StepanenkovAnton/RaspberryPI-MAX11046-ADC-hat/PIC.jpg

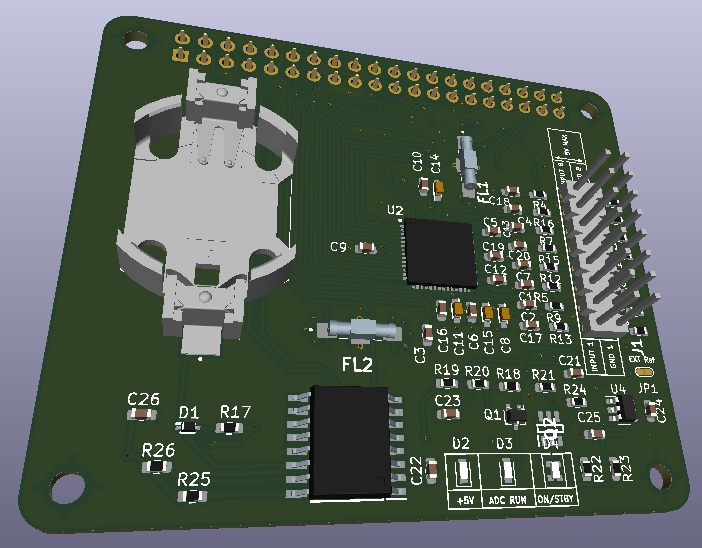
PIC.jpg
