StepanenkovAnton/RaspberryPI-MAX11046-ADC-hat/Manufactoring Documentation/smuHAT_image.jpg

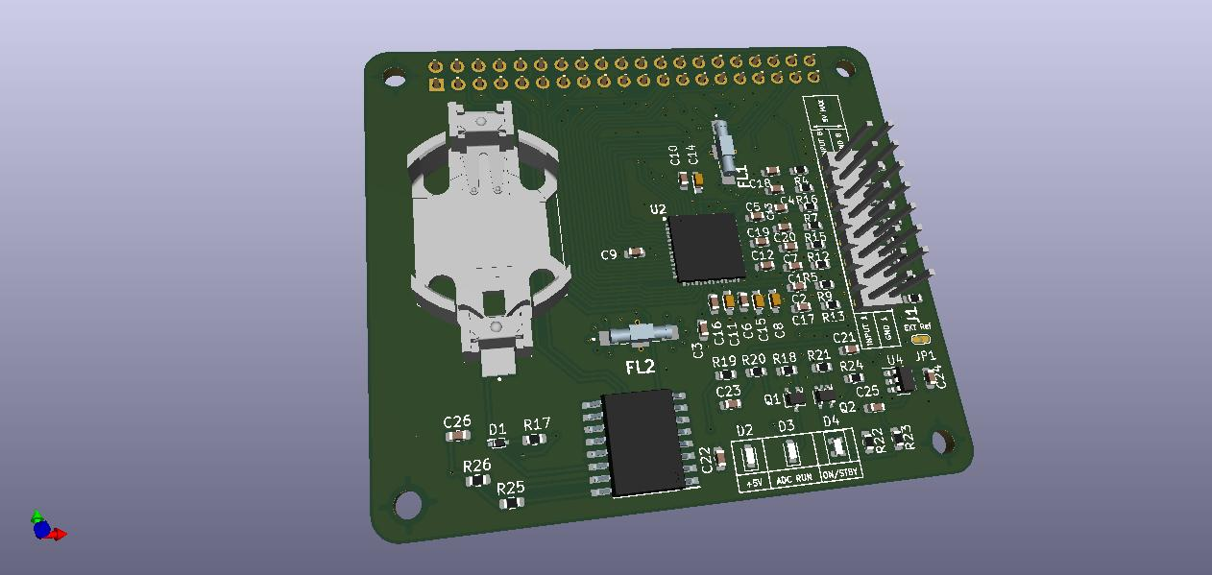
Manufactoring Documentation/smuHAT_image.jpg
