StepanenkovAnton/RaspberryPI-MAX11046-ADC-hat/README.md

# RaspberryPI-MAX11046-ADC-hat
The Raspberry PI add-on boad with the 16 bit 6-channel ADC intended for 3 voltage + 3 current channels high-speed sampling in order to measure the power net
quality parameters like harmonics, power coefficient and so forth.
