StepanenkovAnton/RaspberryPI-MAX11046-ADC-hat/Manufactoring Documentation/LayersStack.jpg

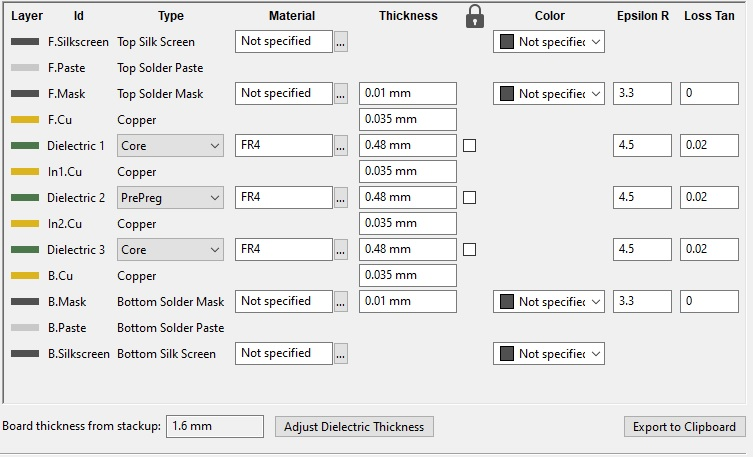
Manufactoring Documentation/LayersStack.jpg
