StepanenkovAnton/RaspberryPI-MAX11046-ADC-hat/Manufactoring Documentation/Bill Of Materials.xlsx

Schematic Position | Value | Footprint | Datasheet | Description | Brand | Mfr. Part number | Qty | Price INR | Total
> C8, C11, C14, C15 | 33uF | smu:CAPPM169X90N | https://www.mouser.in/datasheet/2/40/AVX_F98_DTSH_08_16-1158749.pdf | CAPACITOR TANTALUM SOLID RESIN-MOLDED CHIP, HIGH CV UNDERTAB | KYOCERA AVX (https://www.mouser.in/manufacturer/kyocera-avx/) | F981A336MMALZT | 4 | 64.31 | 257.24
> C3, C5, C6, C9, C10, C12, C16, C19, C21, C22, C26 | 100nF | Capacitor_SMD:C_0603_1608Metric | https://www.mouser.in/datasheet/2/40/AutoMLCC-777028.pdf | Multilayer Ceramic Capacitors MLCC - SMD/SMT 50V 10pF C0G 0603 1% AEC-Q200 | KYOCERA AVX (https://www.mouser.in/manufacturer/kyocera-avx/) | 06035A100F4T4A | 11 | 35 | 385
> C1, C2, C4, C7, C13, C17, C18, C20 | 22nF | Capacitor_SMD:C_0603_1608Metric | https://www.mouser.in/datasheet/2/281/murata_03052018_GRM_Series_1-1310166.pdf | Multilayer Ceramic Capacitors MLCC - SMD/SMT 1500PF 50V 1% 0603 | Murata Electronics (https://www.mouser.in/manufacturer/murataelectronics/) | GRM1885C1H152FA01D | 8 | 13.02 | 104.16
C24 | 1n | Capacitor_SMD:C_0603_1608Metric | https://product.tdk.com/system/files/dam/doc/product/capacitor/ceramic/mlcc/catalog/mlcc_commercial_general_en.pdf | Multilayer Ceramic Capacitors MLCC - SMD/SMT RECOMMENDED ALT 810-C0603X7R1E102K | TDK (https://www.mouser.in/manufacturer/tdk/) | C0603X7R1E102M030BA | 1 | 8.14 | 8.14
> C23, C25 | 10u | Capacitor_SMD:C_0603_1608Metric | https://www.mouser.in/datasheet/2/40/cx5r-776519.pdf | Multilayer Ceramic Capacitors MLCC - SMD/SMT 25V 10uF X5R 0603 20% | KYOCERA AVX (https://www.mouser.in/manufacturer/abracon/) | 06033D106MAT2A | 2 | 29.3 | 58.6
D1 | 1N4148WT | smu:SODFL1608X70N | https://componentsearchengine.com/Datasheets/2/1N4148WT.pdf | ON SEMICONDUCTOR - 1N4148WT - DIODE, SWITCHING, 75V, SOD-523F-2 | onsemi | 1N4148WT | 1 | 16.28 | 16.28
D2 | BLUE | smu:WL-SMCC | https://www.we-online.com/catalog/datasheet/150060BS73220.pdf |  | Wurth Elektronik (https://www.mouser.in/manufacturer/wurth-elektronik/) | 150060BS73220 | 1 | 26.86 | 26.86
D3 | YELLOW | smu:WL-SMCC | https://www.we-online.com/catalog/datasheet/150060YS73220.pdf |  | Wurth Elektronik (https://www.mouser.in/manufacturer/wurth-elektronik/) | 150060YS73220 | 1 | 26.86 | 26.86
D4 | LED_Dual_CCAA | smu:WL-SBCC | https://www.we-online.com/catalog/datasheet/150060RV75240.pdf |  | Wurth Elektronik (https://www.mouser.in/manufacturer/wurth-elektronik/) | 150060RV75240 | 1 | 60.24 | 60.24
> FL1, FL2 | NFE61PT472C1H9L | smu:NFE61 | https://www.murata.com/en-us/products/productdetail?partno=NFE61PT472C1H9%23 | SMT EMI filter capacitor,4700pF 50Vdc Murata NFE61HT / PT Series 2A 50 V dc SMD Power Line Filter, with Solder Pad Terminals | Murata Electronics | NFE61PT472C1H9L | 2 | 63.49 | 126.98
J1 | 5-146253-8 | smu:HDRV16W68P254_2X8_1991X488X1045P | https://www.mouser.fr/datasheet/2/418/6/ENG_CD_146253_J3-2007644.pdf | 16 MODII HDR DRST B/A .100CL LF | TE Connectivity | 5-146253-8 | 1 | 346.76 | 346.76
J2 | RPI_header | Connector_PinSocket_2.54mm:PinSocket_2x20_P2.54mm_Vertical | https://suddendocs.samtec.com/catalog_english/ssq_th.pdf |  | Samtec (https://www.mouser.in/manufacturer/samtec/) | SSQ-120-01-F-D | 1 | 560.85 | 560.85
Q1 | XP231N02013R | Package_TO_SOT_SMD:SOT-323_SC-70 | https://eu.mouser.com/datasheet/2/760/TOSL_S_A0010841704_1-2575097.pdf | MOSFET N-CHANNEL 30V 0.2A |  | Torex Semiconductor (https://www.mouser.in/manufacturer/torex-semiconductor/) | 1 | 28.49 | 28.49
Q2 | SQ1922EEH-T1_GE3 | Package_TO_SOT_SMD:SOT-353_SC-70-5 | https://www.mouser.com.tr/datasheet/2/427/sq1922eeh-1766298.pdf |  |  |  | 1 | 30 | 30
> R1-R3, R6, R8, R10, R11, R14 | 100 | Resistor_SMD:R_0603_1608Metric | https://www.mouser.in/datasheet/2/315/AOA0000C307-1149632.pdf | Thin Film Resistors - SMD 0603 536ohm 0.1% 25ppm | Panasonic (https://www.mouser.in/manufacturer/panasonicec/) | ERA-3AEB5360V | 8 | 28.49 | 227.92
> R4, R5, R7, R9, R12, R13, R15-R17 | 1K | Resistor_SMD:R_0603_1608Metric | https://www.mouser.in/datasheet/2/447/PYu_RC_Group_51_RoHS_L_11-1984063.pdf | Thick Film Resistors - SMD 1 kOhms 100mW 0603 1% | YAGEO (https://www.mouser.in/manufacturer/yageo/) | RC0603FR-071KL | 9 | 8.14 | 73.26
> R18, R21, R24 | 10k | Resistor_SMD:R_0603_1608Metric | https://www.mouser.in/datasheet/2/447/PYu_RC_Group_51_RoHS_L_11-1984063.pdf | Thick Film Resistors - SMD 10 kOhms 100mW 0603 1% | YAGEO (https://www.mouser.in/manufacturer/yageo/) | RC0603FR-0710KL | 3 | 8.14 | 24.42
> R19, R20, R22, R23 | 270 | Resistor_SMD:R_0603_1608Metric | https://www.mouser.in/datasheet/2/447/PYu_AR_51_RoHS_L_7-3003081.pdf | Thick Film Resistors - SMD 270Ohms 1/10W 0603 5% | YAGEO (https://www.mouser.in/manufacturer/yageo/) | AR0603JR-07270RL | 4 | 25.23 | 100.92
> R25, R26 | 2K | Resistor_SMD:R_0603_1608Metric | https://www.mouser.in/datasheet/2/351/Xicon_09112019_XC-600033-1667099.pdf | Thick Film Resistors - SMD 1/10WATT 2KOHMS 5% | Xicon (https://www.mouser.in/manufacturer/xicon/) | SDR03EZPD2001 | 2 | 10 | 20
U1 | SMTU2032-LF | smu:SMTU2032LF | https://www.mouser.com.tr/datasheet/2/427/sq1922eeh-1766298.pdf | Coin Cell Battery Holders SFC MNT FOR CR2032 | RENATA | SMTU2032-LF | 1 | 51.28 | 51.28
U2 | MAX11046ETN+ | smu:QFN50P800X800X80-57N | https://datasheet.datasheetarchive.com/originals/distributors/Datasheets-DGA17/1032187.pdf | MAX11046ETN+, 16 bit ADC 8-channel, Parallel, 56-Pin TQFN | Maxim Integrated | MAX11046ETN+ | 1 | 2882.37 | 2882.37
U3 | DS3231M+TRL | smu:SOIC127P1032X265-16N | http://componentsearchengine.com/Datasheets/1/DS3231M+TRL.pdf | +/-5ppm, I2C Real-Time Clock | Maxim Integrated | DS3231M+TRL | 1 | 789 | 789
U4 | REF34xxT | Package_TO_SOT_SMD:SOT-23-6 | https://www.ti.com/lit/ds/symlink/ref3440.pdf |  |  | Substitute-REF3240AIDBVT | 1 | 602 | 602
 |  |  |  |  |  | REF3440TIDBVR |  | Total | 6807.63
