StepanenkovAnton/RaspberryPI-MAX11046-ADC-hat/Schematic_diagram.pdf

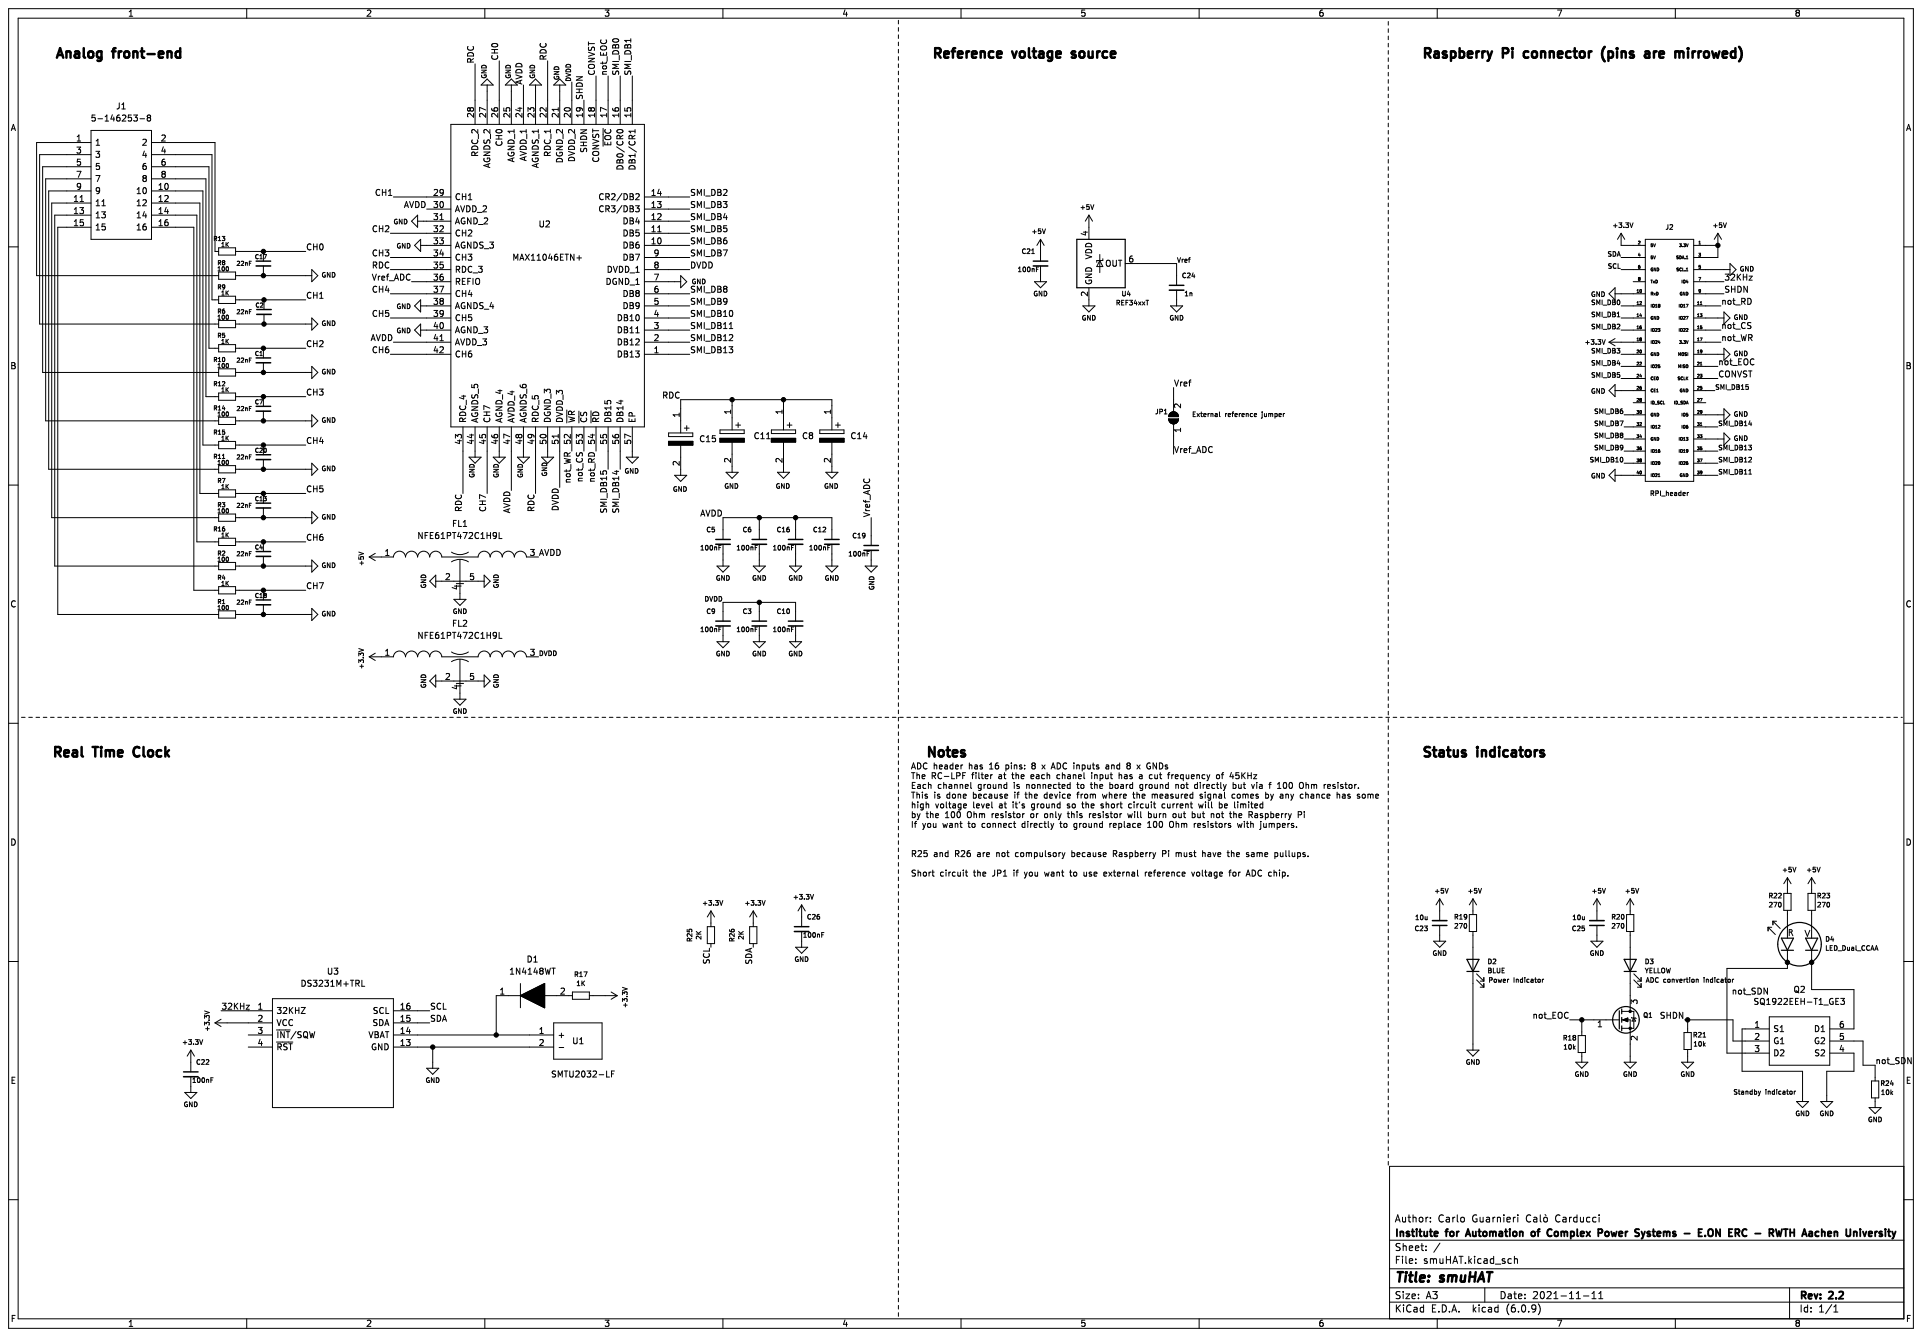
[picture p4: page 1]
