StepanenkovAnton/RaspberryPI-MAX11046-ADC-hat/Manufactoring Documentation/Schematic diagram.pdf

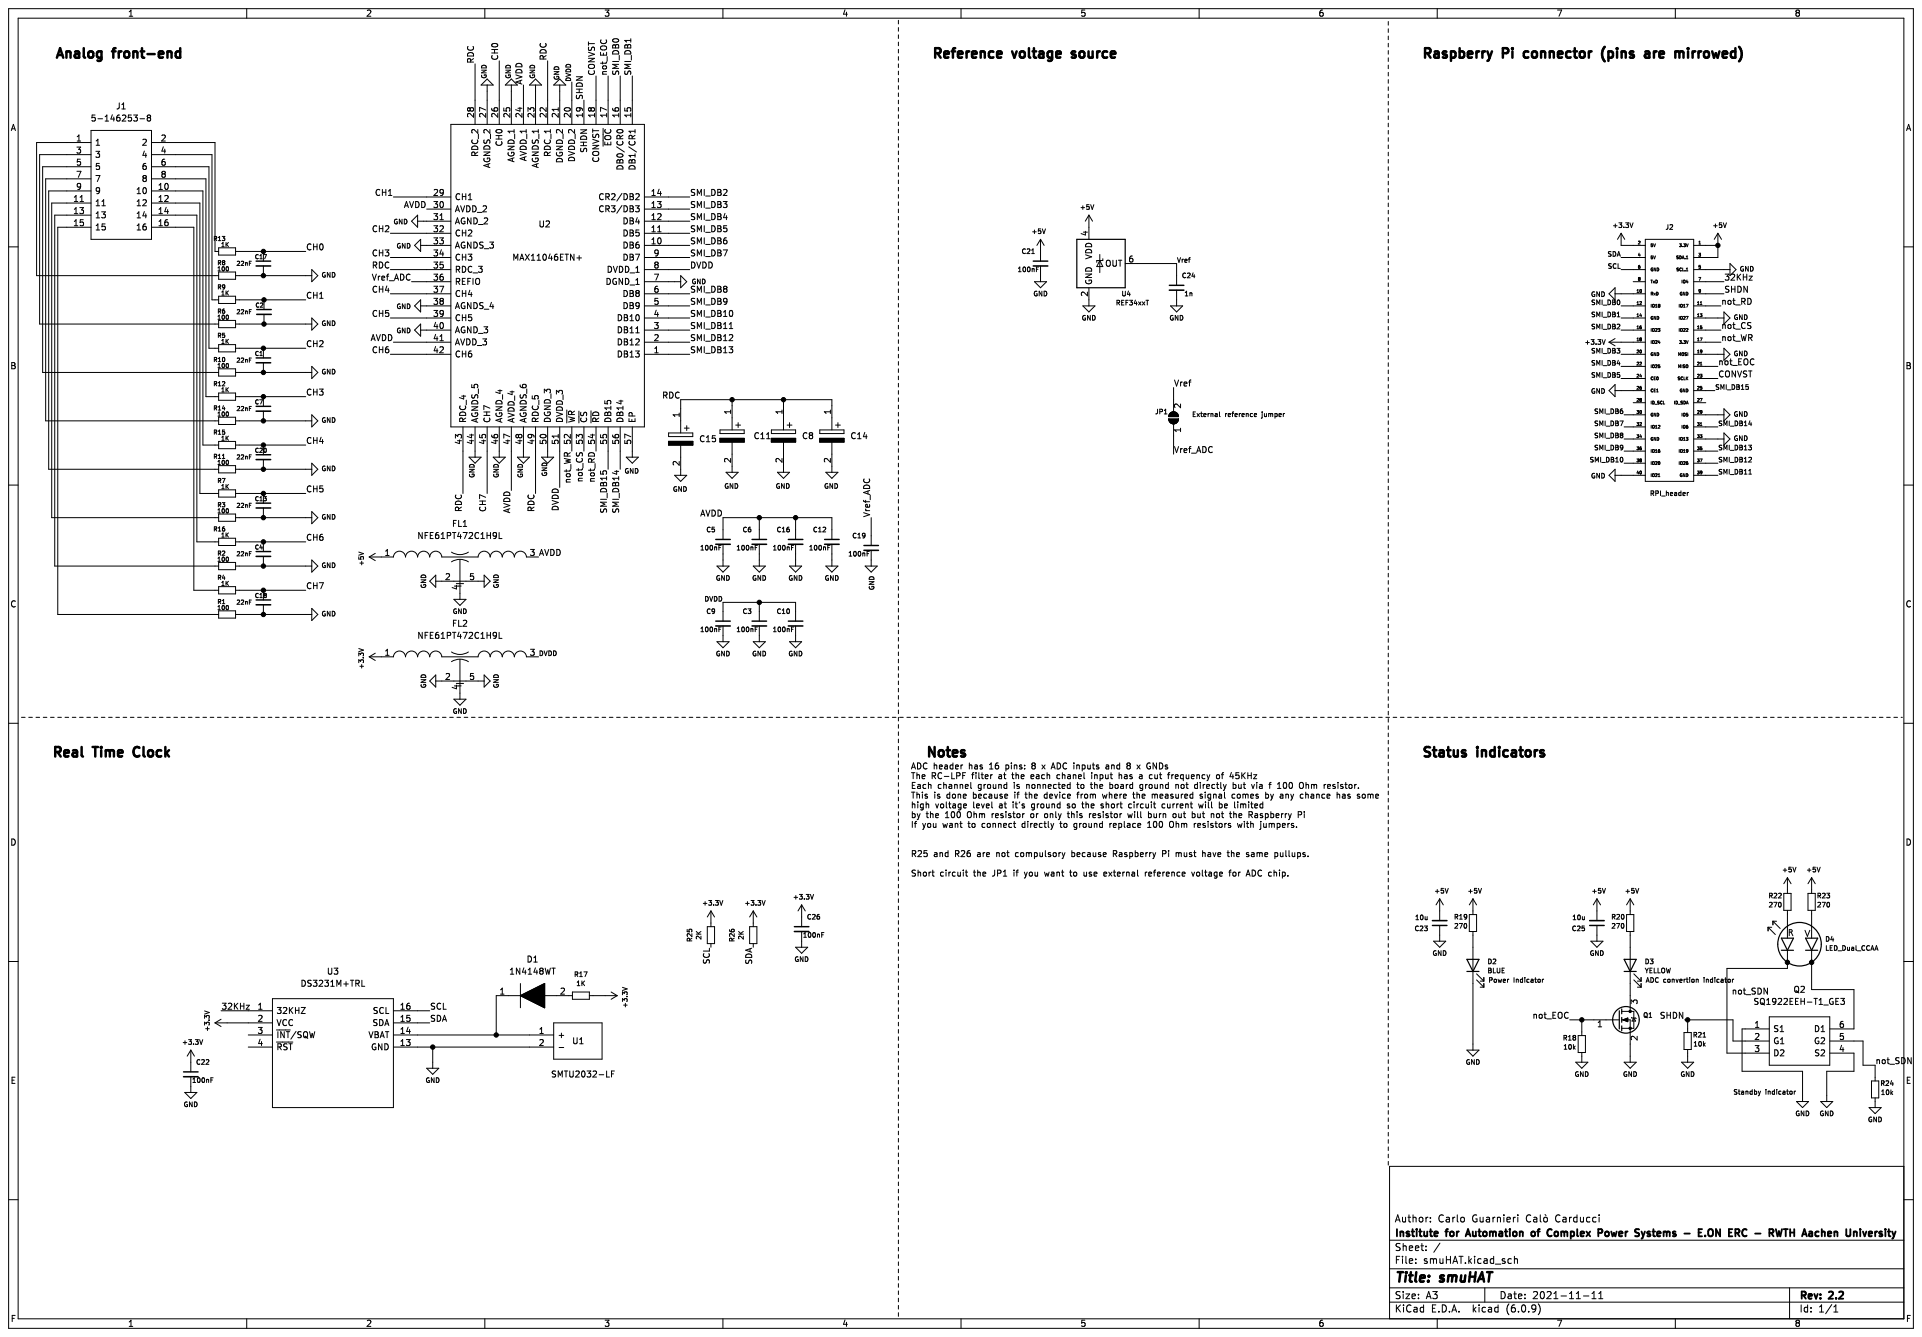
[picture p5: page 1]
