StepanenkovAnton/RaspberryPI-MAX11046-ADC-hat/smuHAT.kicad_pcb

## KiCad design smuHAT.kicad_pcb (2023-01-25)

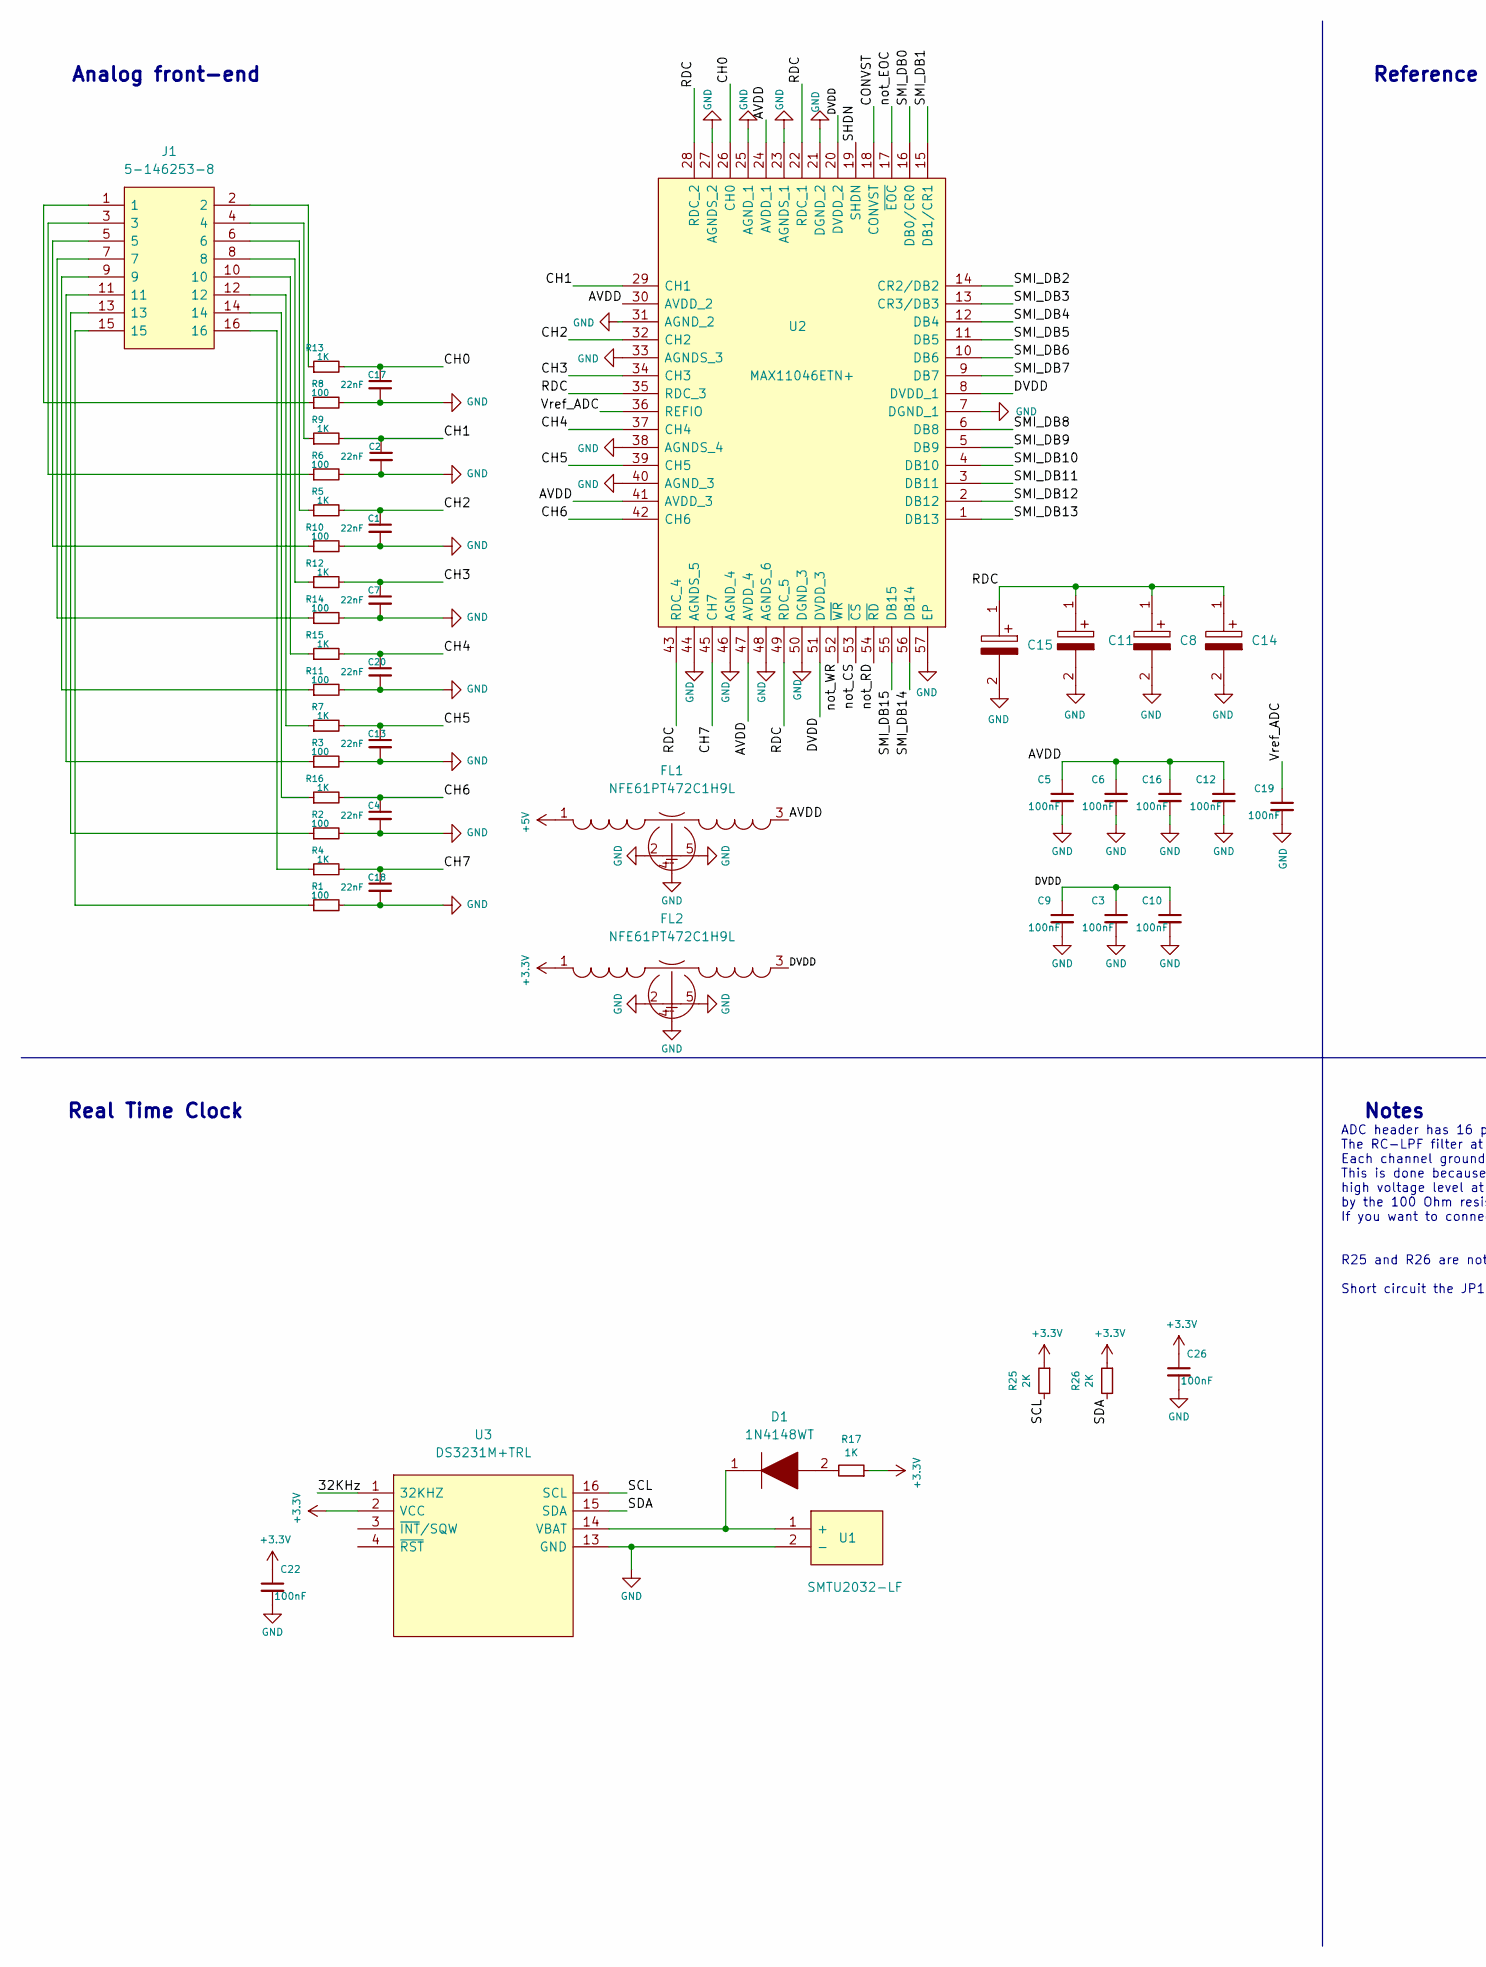
[picture p6: schematic smuHAT.kicad_sch, part in row 1, column 1]

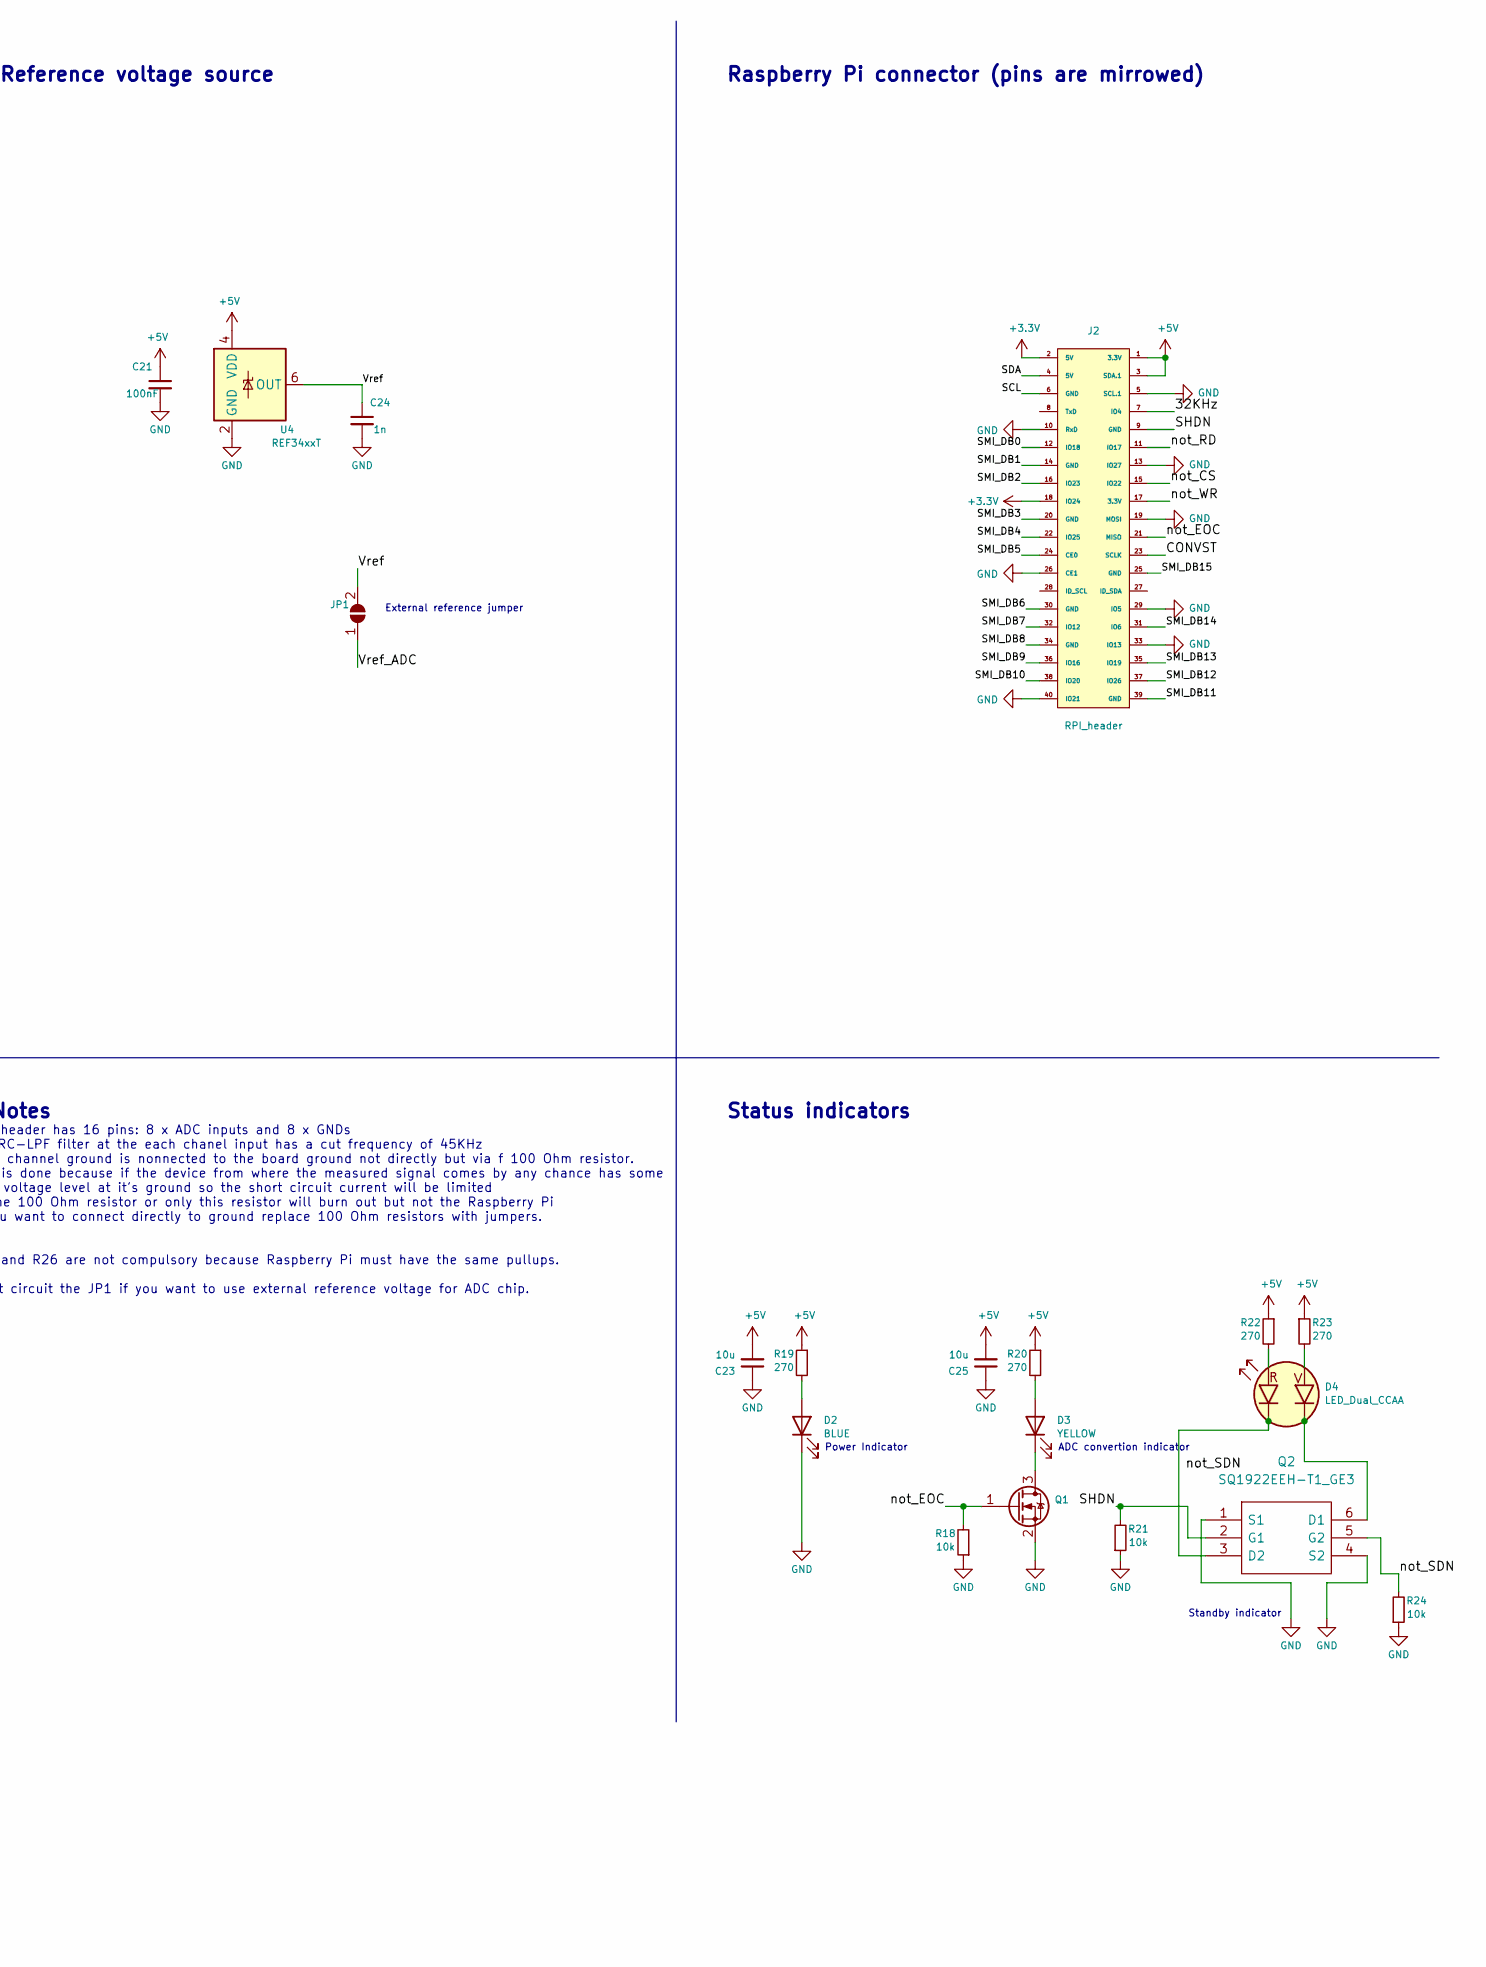
[picture p7: schematic smuHAT.kicad_sch, part in row 1, column 2]

Parts:
C1, C2, C4, C7, C13, C17, C18, C20: 22nF; C_0603_1608Metric
C3, C5, C6, C9, C10, C12, C16, C19, C21, C22, C26: 100nF; C_0603_1608Metric
C8, C11, C14, C15: 33uF; CAPPM169X90N; Mouser Part Number 581-F981A336MMALZT
C23, C25: 10u; C_0603_1608Metric
C24: 1n; C_0603_1608Metric
D1: 1N4148WT; SODFL1608X70N; Mouser Part Number 512-1N4148WT
D2: BLUE; WL-SMCC
D3: YELLOW; WL-SMCC
D4: LED_Dual_CCAA; WL-SBCC
FL1, FL2: NFE61PT472C1H9L; NFE61; Mouser Part Number 81-NFE61PT472C1H9L
J1: 5-146253-8; HDRV16W68P254_2X8_1991X488X1045P; Mouser Part Number 571-5-146253-8
J2: RPI_header; PinSocket_2x20_P2.54mm_Vertical
JP1: External ref. voltage; SolderJumper-2_P1.1mm_Open_RoundedPad0.8x0.9mm
Q1: XP231N02013R; SOT-323_SC-70
Q2: SQ1922EEH-T1_GE3; SOT95P284X110-6N; Mouser Part Number 78-SQ1922EEH-T1_GE3
R1, R2, R3, R6, R8, R10, R11, R14: 100; R_0603_1608Metric
R4, R5, R7, R9, R12, R13, R15, R16, R17: 1K; R_0603_1608Metric
R18, R21, R24: 10k; R_0603_1608Metric
R19, R20, R22, R23: 270; R_0603_1608Metric
R25, R26: 2K; R_0603_1608Metric
U1: SMTU2032-LF; SMTU2032LF; Mouser Part Number 614-SMTU2032-LF
U2: MAX11046ETN+; QFN50P800X800X80-57N; Mouser Part Number 700-MAX11046ETN
U3: DS3231M+TRL; SOIC127P1032X265-16N; Mouser Part Number 700-DS3231M+TRL
U4: REF34xxT; SOT-23-6

Connections:
+3.3V: C22.1, C26.1, FL2.1, J2.2 (5V), J2.18 (IO24), R17.1, R25.1, R26.1, U3.2 (VCC)
+5V: C21.1, C23.2, C25.2, FL1.1, J2.1 (3.3V), J2.3 (SDA.1), R19.1, R20.1, R22.1, R23.1, U4.4 (VDD)
/32KHz: J2.7 (IO4), U3.1 (32KHZ)
/AVDD: C5.1, C6.1, C12.1, C16.1, FL1.3, U2.24 (AVDD_1), U2.30 (AVDD_2), U2.41 (AVDD_3), U2.47 (AVDD_4)
/CH0: C17.1, R13.2, U2.26 (CH0)
/CH1: C2.1, R9.2, U2.29 (CH1)
/CH2: C1.1, R5.2, U2.32 (CH2)
/CH3: C7.1, R12.2, U2.34 (CH3)
/CH4: C20.1, R15.2, U2.37 (CH4)
/CH5: C13.1, R7.2, U2.39 (CH5)
/CH6: C4.1, R16.2, U2.42 (CH6)
/CH7: C18.1, R4.2, U2.45 (CH7)
/CONVST: J2.23 (SCLK), U2.18 (CONVST)
/DVDD: C3.1, C9.1, C10.1, FL2.3, U2.8 (DVDD_1), U2.20 (DVDD_2), U2.51 (DVDD_3)
/RDC: C8.1, C11.1, C14.1, C15.1, U2.22 (RDC_1), U2.28 (RDC_2), U2.35 (RDC_3), U2.43 (RDC_4), U2.49 (RDC_5)
/SCL: J2.6 (GND), R25.2, U3.16 (SCL)
/SDA: J2.4 (5V), R26.2, U3.15 (SDA)
/SHDN: J2.9 (GND), Q2.2 (G1), R21.2, U2.19 (SHDN)
/SMI_DB0: J2.12 (IO18), U2.16 (DB0/CR0)
/SMI_DB1: J2.14 (GND), U2.15 (DB1/CR1)
/SMI_DB2: J2.16 (IO23), U2.14 (CR2/DB2)
/SMI_DB3: J2.20 (GND), U2.13 (CR3/DB3)
/SMI_DB4: J2.22 (IO25), U2.12 (DB4)
/SMI_DB5: J2.24 (CE0), U2.11 (DB5)
/SMI_DB6: J2.30 (GND), U2.10 (DB6)
/SMI_DB7: J2.32 (IO12), U2.9 (DB7)
/SMI_DB8: J2.34 (GND), U2.6 (DB8)
/SMI_DB9: J2.36 (IO16), U2.5 (DB9)
/SMI_DB10: J2.38 (IO20), U2.4 (DB10)
/SMI_DB11: J2.39 (GND), U2.3 (DB11)
/SMI_DB12: J2.37 (IO26), U2.2 (DB12)
/SMI_DB13: J2.35 (IO19), U2.1 (DB13)
/SMI_DB14: J2.31 (IO6), U2.56 (DB14)
/SMI_DB15: J2.25 (GND), U2.55 (DB15)
/Vref: C24.1, JP1.2 (B), U4.6 (OUT)
/Vref_ADC: C19.1, JP1.1 (A), U2.36 (REFIO)
/not_CS: J2.15 (IO22), U2.53 (~CS)
/not_EOC: J2.21 (MISO), Q1.1 (G), R18.2, U2.17 (~EOC)
/not_RD: J2.11 (IO17), U2.54 (~RD)
/not_SDN: Q2.5 (G2), R24.2
/not_WR: J2.17 (3.3V), U2.52 (~WR)
GND: C1.2, C2.2, C3.2, C4.2, C5.2, C6.2, C7.2, C8.2, C9.2, C10.2, C11.2, C12.2, C13.2, C14.2, C15.2, C16.2, C17.2, C18.2, C19.2, C20.2, C21.2, C22.2, C23.1, C24.2, C25.1, C26.2, D2.1 (K), FL1.2, FL1.4, FL1.5, FL2.2, FL2.4, FL2.5, J2.5 (SCL.1), J2.10 (RxD), J2.13 (IO27), J2.19 (MOSI), J2.26 (CE1), J2.29 (IO5), J2.33 (IO13), J2.40 (IO21), Q1.2 (S), Q2.1 (S1), Q2.4 (S2), R1.2, R2.2, R3.2, R6.2, R8.2, R10.2, R11.2, R14.2, R18.1, R21.1, R24.1, U1.2 (-), U2.7 (DGND_1), U2.21 (DGND_2), U2.23 (AGNDS_1), U2.25 (AGND_1), U2.27 (AGNDS_2), U2.31 (AGND_2), U2.33 (AGNDS_3), U2.38 (AGNDS_4), U2.40 (AGND_3), U2.44 (AGNDS_5), U2.46 (AGND_4), U2.48 (AGNDS_6), U2.50 (DGND_3), U2.57 (EP), U3.13 (GND), U4.2 (GND)
unnamed: D1.1, U1.1 (+), U3.14 (VBAT)
unnamed: D1.2, R17.2
unnamed: D2.2 (A), R19.2
unnamed: D3.1 (K), Q1.3 (D)
unnamed: D3.2 (A), R20.2
unnamed: J1.1, R8.1
unnamed: J1.2, R13.1
unnamed: J1.3, R6.1
unnamed: J1.4, R9.1
unnamed: J1.5, R10.1
unnamed: J1.6, R5.1
unnamed: J1.7, R14.1
unnamed: J1.8, R12.1
unnamed: J1.9, R11.1
unnamed: J1.10, R15.1
unnamed: J1.11, R3.1
unnamed: J1.12, R7.1
unnamed: J1.13, R2.1
unnamed: J1.14, R16.1
unnamed: J1.15, R1.1
unnamed: J1.16, R4.1
unnamed: D4.2 (K1), Q2.3 (D2)
unnamed: D4.1 (K2), Q2.6 (D1)
unnamed: D4.3 (A1), R22.2
unnamed: D4.4 (A2), R23.2

Notes on the sheet:
External reference jumper
Raspberry Pi connector (pins are mirrowed)
Real Time Clock
Standby indicator
Power Indicator
Status indicators
ADC convertion indicator
Reference voltage source
ADC header has 16 pins: 8 x ADC inputs and 8 x GNDs The RC-LPF filter at the each chanel input has a cut frequency of 45KHz Each channel ground is nonnected to the board ground not directly but via f 100 Ohm resistor. This is done because if the device from where the measured signal comes by any ch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
Notes
Analog front-end

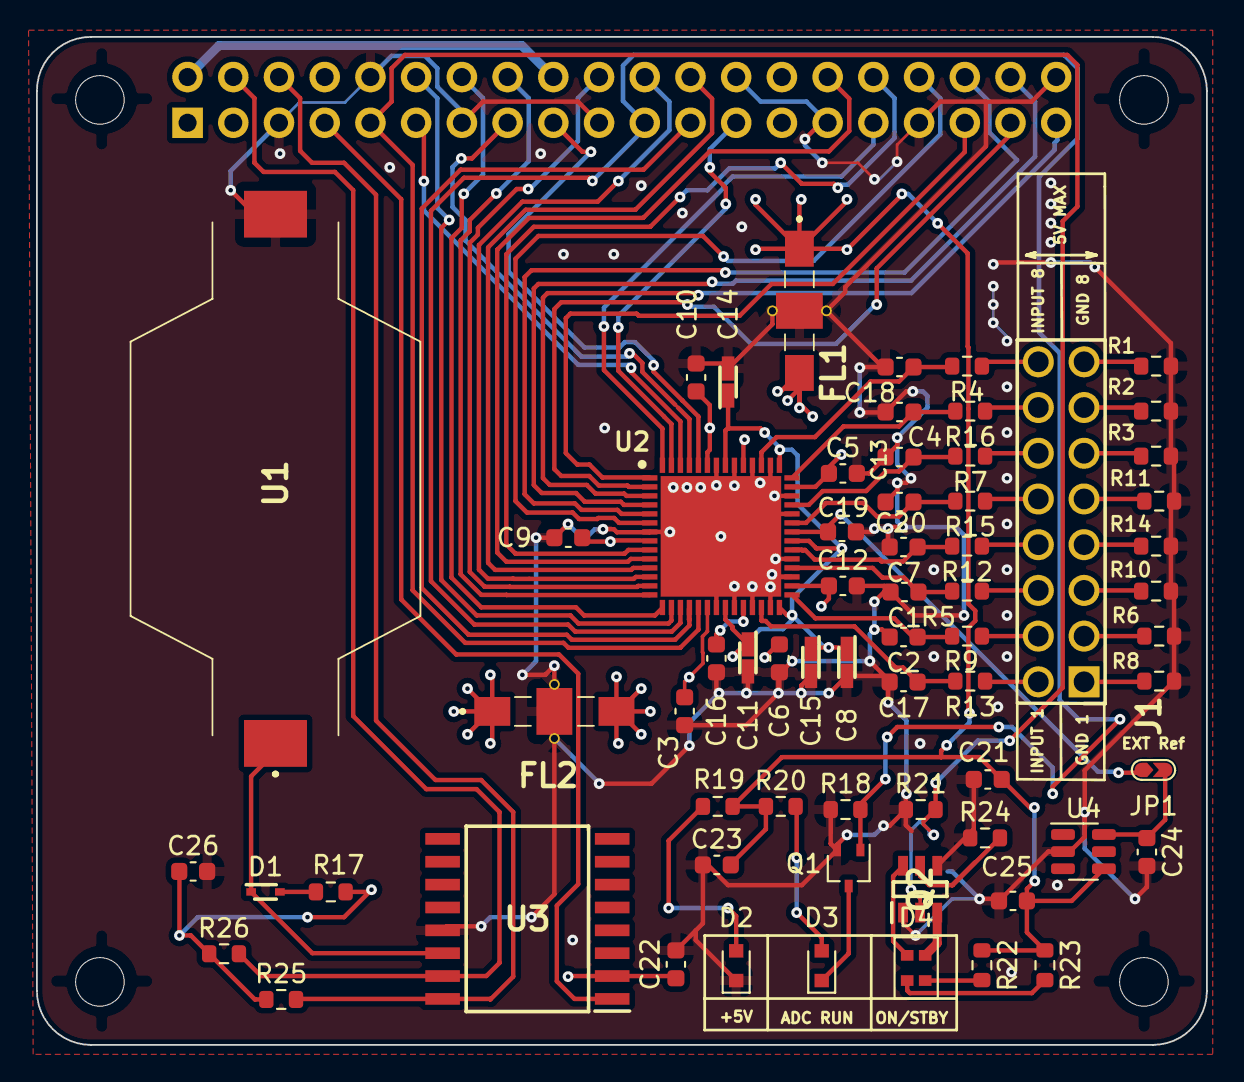
[picture p8: board smuHAT.kicad_pcb from above]

Board: 4 copper layers, 65.0 x 56.0 mm, 67 parts (1 on the bottom side), 67 nets.
