StepanenkovAnton/RaspberryPI-MAX11046-ADC-hat/(notices)

Notices in the files:
smuHAT.kicad_pcb:
License: Creative Commons Attribution 4.0 International License
